andreasb242/WordClockPcb/Board-sw.png

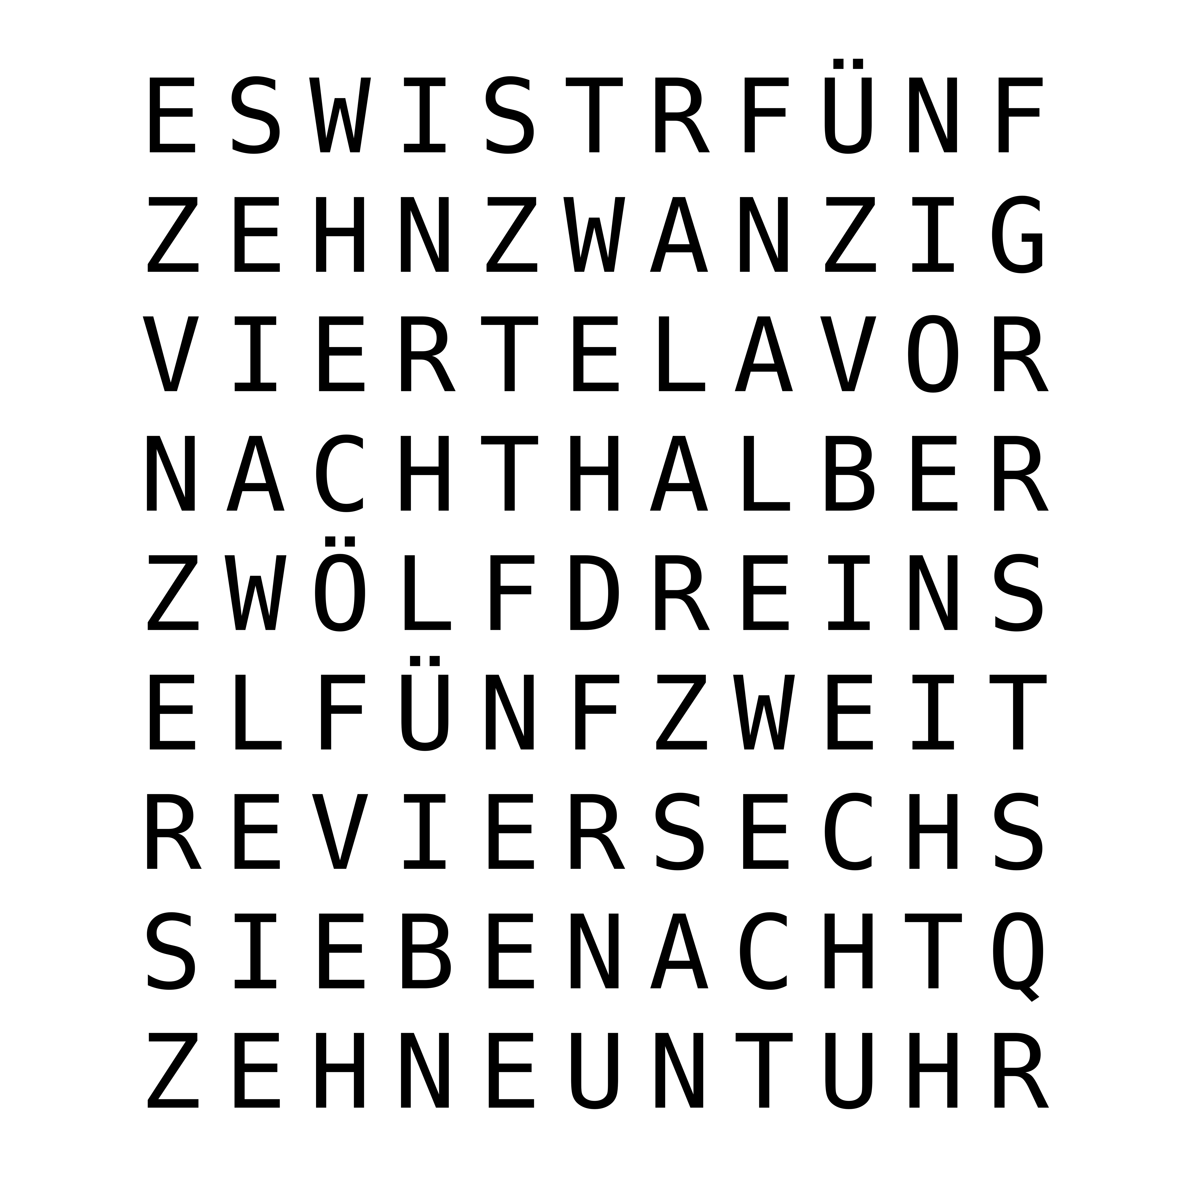
Board-sw.png
