andreasb242/WordClockPcb/Board-ws.png

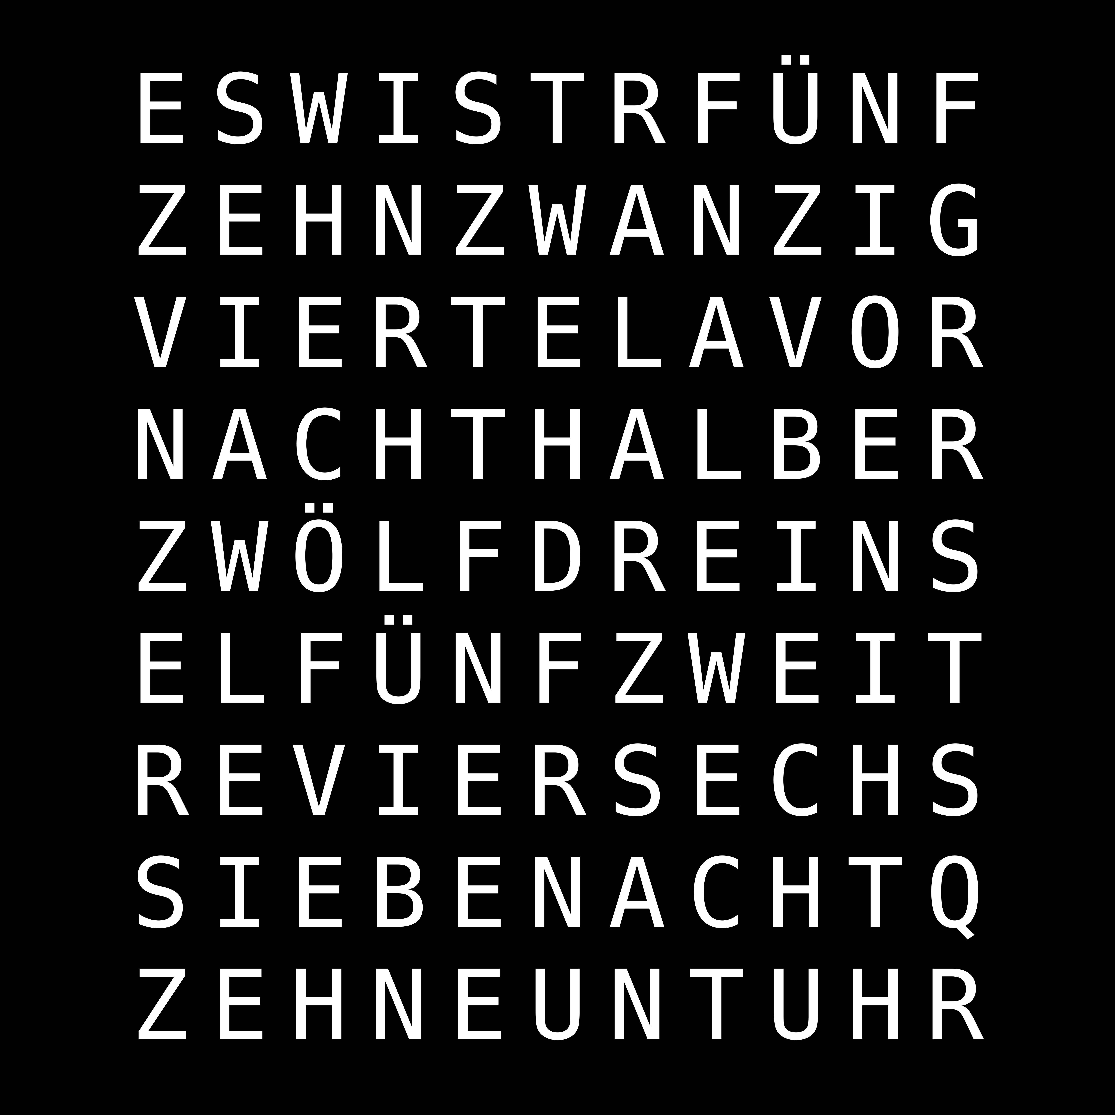
Board-ws.png
