andreasb242/WordClockPcb/ElektronikV2/gerber/BOM-Elektronik.csv.jlcpcb.xlsx

Comment | Designator | Footprint | LCSC Part #（optional）
Conn_01x04 | J10 | PinHeader_1x04_P2.54mm_Vertical | x
1kΩ | R535,R534,R533,R532,R529 | R_0402_1005Metric | C11702
blue | D535,D534,D533,D532,D529 | LED_0805_2012Metric_Pad1.15x1.40mm_HandSolder | C72041
CH552G | U6 | SOP-16_4.4x10.4mm_P1.27mm | C111292
Conn_01x02_Male | J9,J8,J7,J6 | PinHeader_1x02_P2.54mm_Vertical | x
Conn_01x05_Male | J5 | PinHeader_1x05_P2.54mm_Vertical | x
1uF | C9,C6 | C_0603_1608Metric | C15849
100nF | C8,C7,C5,C4,C3,C2,C1 | C_0603_1608Metric | C14663
TestPoint | TP3,TP2,TP1 | TestPoint_Pad_1.5x1.5mm
Crystal | Y1 | Crystal_SMD_3215-2Pin_3.2x1.5mm
PCF8563T | U5 | SOIC-8_3.9x4.9mm_P1.27mm | C7440
4.7kΩ | R531,R530 | R_0402_1005Metric | C25900
SM4007PL | D531,D530 | D_SOD-123F | C64898
Rled | R408,R407,R406,R405,R404,R403,R528,R527,R526,R525,R524,R523,R522,R521,R520,R519,R518,R517,R516,R515,R514,R513,R512,R511,R510,R509,R508,R507,R506,R505,R504,R503,R502,R501,R500,R499,R498,R497,R496,R495,R494,R493,R492,R491,R490,R489,R488,R487,R486,R485,R484,R483,R482,R481,R480,R479,R478,R477,R476,R475,R474,R473,R472,R471,R470,R469,R468,R467,R466,R465,R464,R463,R462,R461,R460,R459,R458,R457,R456,R455,R454,R453,R452,R451,R450,R449,R448,R447,R446,R445,R444,R443,R442,R441,R440,R439,R438,R437,R436,R435,R434,R433,R432,R431,R430,R429,R428,R427,R426,R425,R424,R423,R422,R421,R420,R419,R418,R417,R416,R415,R414,R413,R412,R411,R410,R409,R402,R401,R400,R399,R398,R397,R396,R395,R394,R393,R392,R391,R390,R389,R388,R387,R386,R385,R384,R383,R382,R381,R380,R379,R378,R377,R376,R375,R374,R373,R372,R371,R370,R369,R368,R367,R366,R365,R364,R363,R362,R361,R360,R359,R358,R357,R356,R355,R354,R353,R352,R351,R350,R349,R348,R347,R346,R345,R344,R343,R342,R341,R340,R339,R338,R337,R336,R335,R334,R333,R332,R331,R330,R329,R328,R327,R326,R325,R324,R323,R322,R321,R320,R319,R318,R317,R316,R315,R314,R313,R312,R311,R310,R309,R308,R307,R306,R305,R304,R303,R302,R301,R300,R299,R298,R297,R296,R295,R294,R293,R292,R291,R290,R289,R288,R287,R286,R285,R284,R283,R282,R281,R280,R279,R278,R277,R276,R275,R274,R273,R272,R271,R270,R269,R268,R267,R266,R265,R264,R263,R262,R261,R260,R259,R258,R257,R256,R255,R254,R253,R252,R251,R250,R249,R248,R247,R246,R245,R244,R243,R242,R241,R240,R239,R238,R237,R236,R235,R234,R233,R232,R231,R230,R22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 | R_0402_1005Metric
LEDCLOCK | D408,D407,D406,D405,D404,D403,D528,D527,D526,D525,D524,D523,D522,D521,D520,D519,D518,D517,D516,D515,D514,D513,D512,D511,D510,D509,D508,D507,D506,D505,D504,D503,D502,D501,D500,D499,D498,D497,D496,D495,D494,D493,D492,D491,D490,D489,D488,D487,D486,D485,D484,D483,D482,D481,D480,D479,D478,D477,D476,D475,D474,D473,D472,D471,D470,D469,D468,D467,D466,D465,D464,D463,D462,D461,D460,D459,D458,D457,D456,D455,D454,D453,D452,D451,D450,D449,D448,D447,D446,D445,D444,D443,D442,D441,D440,D439,D438,D437,D436,D435,D434,D433,D432,D431,D430,D429,D428,D427,D426,D425,D424,D423,D422,D421,D420,D419,D418,D417,D416,D415,D414,D413,D412,D411,D410,D409,D402,D401,D400,D399,D398,D397,D396,D395,D394,D393,D392,D391,D390,D389,D388,D387,D386,D385,D384,D383,D382,D381,D380,D379,D378,D377,D376,D375,D374,D373,D372,D371,D370,D369,D368,D367,D366,D365,D364,D363,D362,D361,D360,D359,D358,D357,D356,D355,D354,D353,D352,D351,D350,D349,D348,D347,D346,D345,D344,D343,D342,D341,D340,D339,D338,D337,D336,D335,D334,D333,D332,D331,D330,D329,D328,D327,D326,D325,D324,D323,D322,D321,D320,D319,D318,D317,D316,D315,D314,D313,D312,D311,D310,D309,D308,D307,D306,D305,D304,D303,D302,D301,D300,D299,D298,D297,D296,D295,D294,D293,D292,D291,D290,D289,D288,D287,D286,D285,D284,D283,D282,D281,D280,D279,D278,D277,D276,D275,D274,D273,D272,D271,D270,D269,D268,D267,D266,D265,D264,D263,D262,D261,D260,D259,D258,D257,D256,D255,D254,D253,D252,D251,D250,D249,D248,D247,D246,D245,D244,D243,D242,D241,D240,D239,D238,D237,D236,D235,D234,D233,D232,D231,D230,D22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 | LED_0603_1608Metric
74HC595 | U4,U3,U2,U1 | SOIC-16_3.9x9.9mm_P1.27mm | C5947
MountingHole_Pad | H4,H3,H2,H1 | MountingHole_4.3mm_M4_Pad_Via | x
Conn_02x04_Counter_Clockwise | J4,J3,J2,J1 | PinHeader_2x04_P2.54mm_Vertical | x
Graphics | G2 | sw
