andreasb242/WordClockPcb/ElektronikV2/Elektronik.kicad_pcb

## KiCad design ElektronikV2/Elektronik.kicad_pcb (2020-09-25)

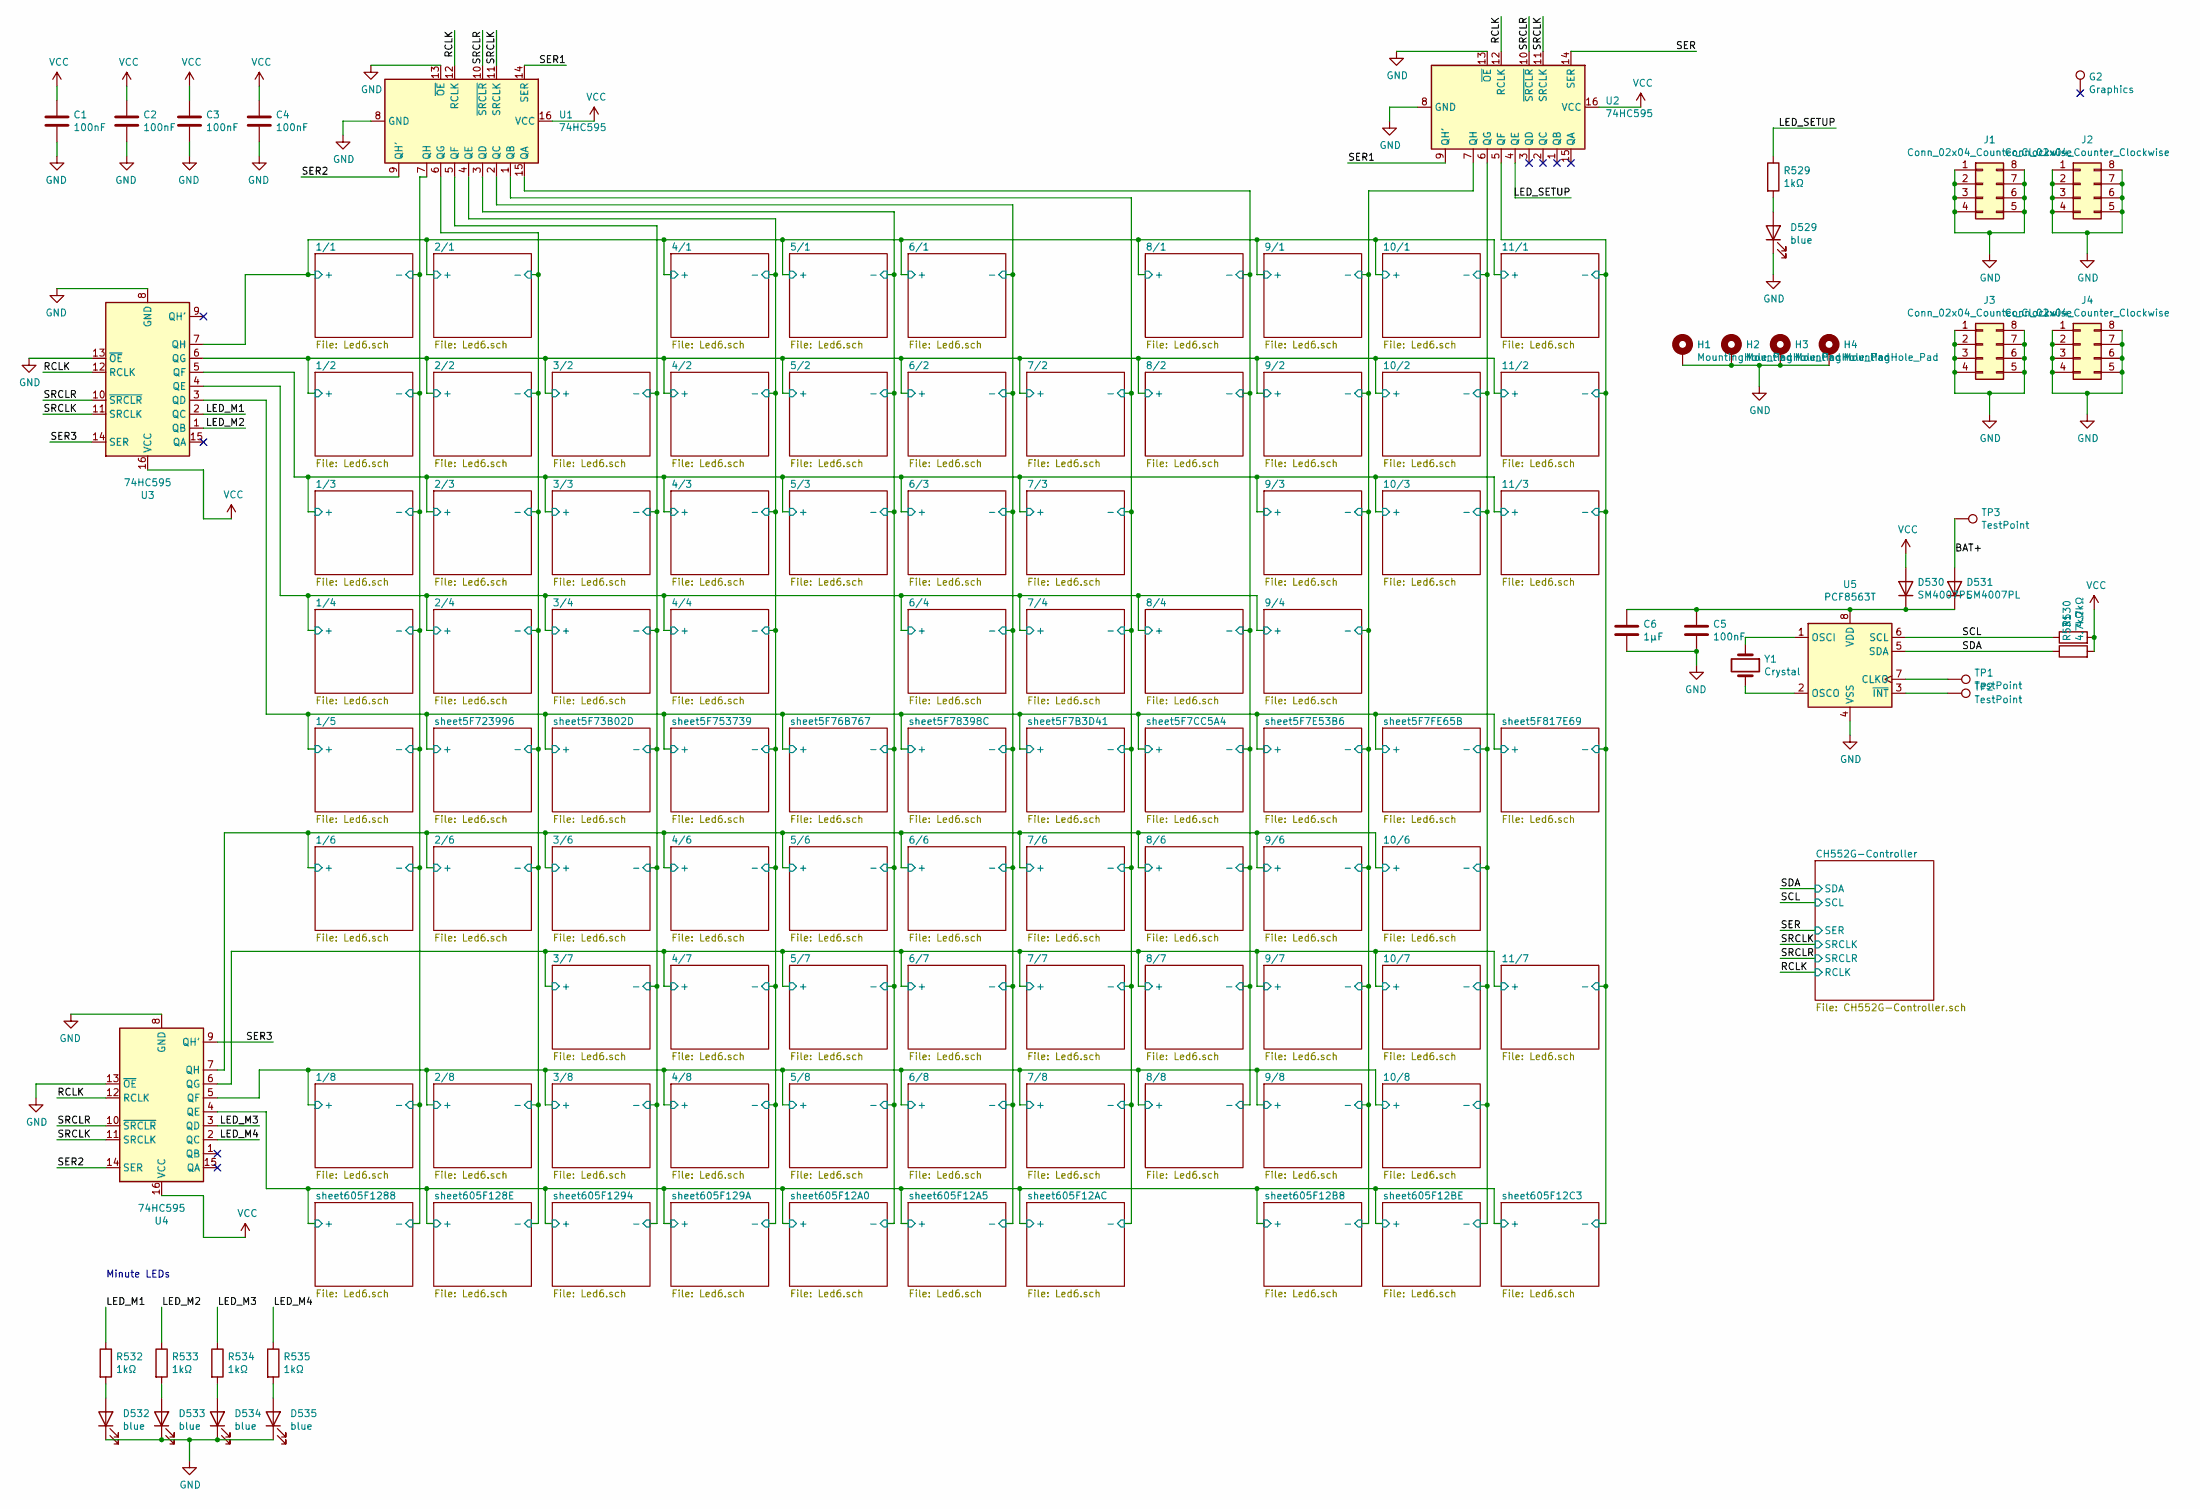
[picture p3: schematic Elektronik.sch]

Parts:
C1, C2, C3, C4, C5: 100nF; C_0603_1608Metric
C6: 1µF; C_0603_1608Metric
D529, D532, D533, D534, D535: blue; LED_0805_2012Metric_Pad1.15x1.40mm_HandSolder
D530, D531: SM4007PL; D_SOD-123F
G2: Graphics; sw
H1, H2, H3, H4: MountingHole_Pad; MountingHole_4.3mm_M4_Pad_Via
J1, J2, J3, J4: Conn_02x04_Counter_Clockwise; PinHeader_2x04_P2.54mm_Vertical
R529, R532, R533, R534, R535: 1kΩ; R_0402_1005Metric
R530, R531: 4.7kΩ; R_0402_1005Metric
TP1, TP2, TP3: TestPoint; TestPoint_Pad_1.5x1.5mm
U1, U2, U3, U4: 74HC595; SOIC-16_3.9x9.9mm_P1.27mm
U5: PCF8563T; SOIC-8_3.9x4.9mm_P1.27mm
Y1: Crystal; Crystal_SMD_3215-2Pin_3.2x1.5mm

Connections:
/1/1/+: U3.7 (QH); also elsewhere on the board
/1/1/-: U1.7 (QH); also elsewhere on the board
/1/2/+: U3.6 (QG); also elsewhere on the board
/1/3/+: U3.5 (QF); also elsewhere on the board
/1/4/+: U3.4 (QE); also elsewhere on the board
/1/5/+: U3.3 (QD); also elsewhere on the board
/1/6/+: U4.7 (QH); also elsewhere on the board
/1/8/+: U4.5 (QF); also elsewhere on the board
/2/1/-: U1.6 (QG); also elsewhere on the board
/3/2/-: U1.5 (QF); also elsewhere on the board
/4/1/-: U1.4 (QE); also elsewhere on the board
/5/1/-: U1.3 (QD); also elsewhere on the board
/6/1/-: U1.2 (QC); also elsewhere on the board
/7/2/-: U1.1 (QB); also elsewhere on the board
/8/1/-: U1.15 (QA); also elsewhere on the board
/9/1/-: U2.7 (QH); also elsewhere on the board
/10/1/-: U2.6 (QG); also elsewhere on the board
/10/7/+: U4.6 (QG); also elsewhere on the board
/11/1/-: U2.5 (QF); also elsewhere on the board
/BAT+: D531.2 (A), TP3.1
/LED_M1: R532.1, U3.2 (QC)
/LED_M2: R533.1, U3.1 (QB)
/LED_M3: R534.1, U4.3 (QD)
/LED_M4: R535.1, U4.2 (QC)
/LED_SETUP: R529.1, U2.4 (QE)
/RCLK: U1.12 (RCLK), U2.12 (RCLK), U3.12 (RCLK), U4.12 (RCLK); also elsewhere on the board
/SCL: R530.1, U5.6 (SCL); also elsewhere on the board
/SDA: R531.1, U5.5 (SDA); also elsewhere on the board
/SER: U2.14 (SER); also elsewhere on the board
/SER1: U1.14 (SER), U2.9 (QH')
/SER2: U1.9 (QH'), U4.14 (SER)
/SER3: U3.14 (SER), U4.9 (QH')
/SRCLK: U1.11 (SRCLK), U2.11 (SRCLK), U3.11 (SRCLK), U4.11 (SRCLK); also elsewhere on the board
/SRCLR: U1.10 (~SRCLR), U2.10 (~SRCLR), U3.10 (~SRCLR), U4.10 (~SRCLR); also elsewhere on the board
/sheet605F1288/+: U4.4 (QE); also elsewhere on the board
GND: C1.2, C2.2, C3.2, C4.2, C5.2, C6.2, D529.1 (K), D532.1 (K), D533.1 (K), D534.1 (K), D535.1 (K), H1.1, H2.1, H3.1, H4.1, J1.1, J1.2, J1.3, J1.4, J1.5, J1.6, J1.7, J1.8, J2.1, J2.2, J2.3, J2.4, J2.5, J2.6, J2.7, J2.8, J3.1, J3.2, J3.3, J3.4, J3.5, J3.6, J3.7, J3.8, J4.1, J4.2, J4.3, J4.4, J4.5, J4.6, J4.7, J4.8, U1.8 (GND), U1.13 (~OE), U2.8 (GND), U2.13 (~OE), U3.8 (GND), U3.13 (~OE), U4.8 (GND), U4.13 (~OE), U5.4 (VSS); also elsewhere on the board
unnamed: C5.1, C6.1, D530.1 (K), D531.1 (K), U5.8 (VDD)
unnamed: D529.2 (A), R529.2
unnamed: D532.2 (A), R532.2
unnamed: D533.2 (A), R533.2
unnamed: D534.2 (A), R534.2
unnamed: D535.2 (A), R535.2
unnamed: TP1.1, U5.7 (CLKO)
unnamed: TP2.1, U5.3 (~INT~)
unnamed: U5.1 (OSCI), Y1.1
unnamed: U5.2 (OSCO), Y1.2
VCC: C1.1, C2.1, C3.1, C4.1, D530.2 (A), R530.2, R531.2, U1.16 (VCC), U2.16 (VCC), U3.16 (VCC), U4.16 (VCC); also elsewhere on the board

Notes on the sheet:
Minute LEDs
