andreasb242/WordClockPcb/ElektronikV2/Elektronik.kicad_pcb

## KiCad design ElektronikV2/Elektronik.kicad_pcb (continued)

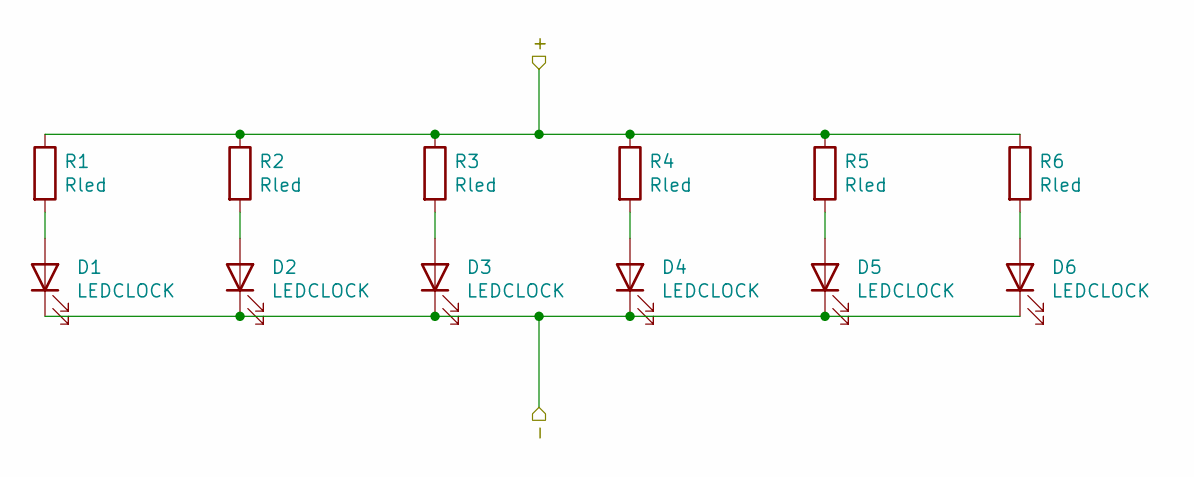
[picture p4: schematic Led6.sch]

Parts:
D1, D2, D3, D4, D5, D6: LEDCLOCK; LED_0603_1608Metric
R1, R2, R3, R4, R5, R6: Rled; R_0402_1005Metric

Connections:
/1/1/+: R1.1, R2.1, R3.1, R4.1, R5.1, R6.1; also elsewhere on the board
/1/1/-: D1.1 (K), D2.1 (K), D3.1 (K), D4.1 (K), D5.1 (K), D6.1 (K); also elsewhere on the board
unnamed: D1.2 (A), R1.2
unnamed: D2.2 (A), R2.2
unnamed: D3.2 (A), R3.2
unnamed: D4.2 (A), R4.2
unnamed: D5.2 (A), R5.2
unnamed: D6.2 (A), R6.2

Parts of its further copies:
D7, D8, D9, D10, D11, D12, D13, D14, D15, D16, D17, D18, D19, D20, D21, D22, D23, D24, D25, D26, D27, D28, D29, D30, D31, D32, D33, D34, D35, D36, D37, D38, D39, D40, D41, D42, D43, D44, D45, D46, D47, D48, D49, D50, D51, D52, D53, D54, D55, D56, D57, D58, D59, D60, D61, D62, D63, D64, D65, D66, D67, D68, D69, D70, D71, D72, D73, D74, D75, D76, D77, D78, D79, D80, D81, D82, D83, D84, D85, D86, D87, D88, D89, D90, D91, D92, D93, D94, D95, D96, D97, D98, D99, D100, D101, D102, D103, D104, D105, D106, D107, D108, D109, D110, D111, D112, D113, D114, D115, D116, D117, D118, D119, D120, D121, D122, D123, D124, D125, D126, D127, D128, D129, D130, D131, D132, D133, D134, D135, D136, D137, D138, D139, D140, D141, D142, D143, D144, D145, D146, D147, D148, D149, D150, D151, D152, D153, D154, D155, D156, D157, D158, D159, D160, D161, D162, D163, D164, D165, D166, D167, D168, D169, D170, D171, D172, D173, D174, D175, D176, D177, D178, D179, D180, D181, D182, D183, D184, D185, D186, D187, D188, D189, D190, D191, D192, D193, D194, D195, D196, D197, D198, D199, D200, D201, D202, D203, D204, D205, D206, D207, D208, D209, D210, D211, D212, D213, D214, D215, D216, D217, D218, D219, D220, D221, D222, D223, D224, D225, D226, D227, D228, D229, D230, D231, D232, D233, D234, D235, D236, D237, D238, D239, D240, D241, D242, D243, D244, D245, D246, D247, D248, D249, D250, D251, D252, D253, D254, D255, D256, D257, D258, D259, D260, D261, D262, D263, D264, D265, D266, D267, D268, D269, D270, D271, D272, D273, D274, D275, D276, D277, D278, D279, D280, D281, D282, D283, D284, D285, D286, D287, D288, D289, D290, D291, D292, D293, D294, D295, D296, D297, D298, D299, D300, D301, D302, D303, D304, D305, D306, D307, D308, D309, D310, D311, D312, D313, D314, D315, D316, D317, D318, D319, D320, D321, D322, D323, D324, D325, D326, D327, D328, D329, D330, D331, D332, D333, D334, D335, D336, D337, D338, D339, D340, D341, D342, D343, D344, D345, D346, D347, D348, D349, D350, D351, D352, D353, D354, D355, D356, D357, D358, D359, D360, D361, D362, D363, D364, D365, D366, D367, D368, D369, D370, D371, D372, D373, D374, D375, D376, D377, D378, D379, D380, D381, D382, D383, D384, D385, D386, D387, D388, D389, D390, D391, D392, D393, D394, D395, D396, D397, D398, D399, D400, D401, D402, D403, D404, D405, D406, D407, D408, D409, D410, D411, D412, D413, D414, D415, D416, D417, D418, D419, D420, D421, D422, D423, D424, D425, D426, D427, D428, D429, D430, D431, D432, D433, D434, D435, D436, D437, D438, D439, D440, D441, D442, D443, D444, D445, D446, D447, D448, D449, D450, D451, D452, D453, D454, D455, D456, D457, D458, D459, D460, D461, D462, D463, D464, D465, D466, D467, D468, D469, D470, D471, D472, D473, D474, D475, D476, D477, D478, D479, D480, D481, D482, D483, D484, D485, D486, D487, D488, D489, D490, D491, D492, D493, D494, D495, D496, D497, D498, D499, D500, D501, D502, D503, D504, D505, D506, D507, D508, D509, D510, D511, D512, D513, D514, D515, D516, D517, D518, D519, D520, D521, D522, D523, D524, D525, D526, D527, D528: LEDCLOCK; LED_0603_1608Metric
R7, R8, R9, R10, R11, R12, R13, R14, R15, R16, R17, R18, R19, R20, R21, R22, R23, R24, R25, R26, R27, R28, R29, R30, R31, R32, R33, R34, R35, R36, R37, R38, R39, R40, R41, R42, R43, R44, R45, R46, R47, R48, R49, R50, R51, R52, R53, R54, R55, R56, R57, R58, R59, R60, R61, R62, R63, R64, R65, R66, R67, R68, R69, R70, R71, R72, R73, R74, R75, R76, R77, R78, R79, R80, R81, R82, R83, R84, R85, R86, R87, R88, R89, R90, R91, R92, R93, R94, R95, R96, R97, R98, R99, R100, R101, R102, R103, R104, R105, R106, R107, R108, R109, R110, R111, R112, R113, R114, R115, R116, R117, R118, R119, R120, R121, R122, R123, R124, R125, R126, R127, R128, R129, R130, R131, R132, R133, R134, R135, R136, R137, R138, R139, R140, R141, R142, R143, R144, R145, R146, R147, R148, R149, R150, R151, R152, R153, R154, R155, R156, R157, R158, R159, R160, R161, R162, R163, R164, R165, R166, R167, R168, R169, R170, R171, R172, R173, R174, R175, R176, R177, R178, R179, R180, R181, R182, R183, R184, R185, R186, R187, R188, R189, R190, R191, R192, R193, R194, R195, R196, R197, R198, R199, R200, R201, R202, R203, R204, R205, R206, R207, R208, R209, R210, R211, R212, R213, R214, R215, R216, R217, R218, R219, R220, R221, R222, R223, R224, R225, R226, R227, R228, R229, R230, R231, R232, R233, R234, R235, R236, R237, R238, R239, R240, R241, R242, R243, R244, R245, R246, R247, R248, R249, R250, R251, R252, R253, R254, R255, R256, R257, R258, R259, R260, R261, R262, R263, R264, R265, R266, R267, R268, R269, R270, R271, R272, R273, R274, R275, R276, R277, R278, R279, R280, R281, R282, R283, R284, R285, R286, R287, R288, R289, R290, R291, R292, R293, R294, R295, R296, R297, R298, R299, R300, R301, R302, R303, R304, R305, R306, R307, R308, R309, R310, R311, R312, R313, R314, R315, R316, R317, R318, R319, R320, R321, R322, R323, R324, R325, R326, R327, R328, R329, R330, R331, R332, R333, R334, R335, R336, R337, R338, R339, R340, R341, R342, R343, R344, R345, R346, R347, R348, R349, R350, R351, R352, R353, R354, R355, R356, R357, R358, R359, R360, R361, R362, R363, R364, R365, R366, R367, R368, R369, R370, R371, R372, R373, R374, R375, R376, R377, R378, R379, R380, R381, R382, R383, R384, R385, R386, R387, R388, R389, R390, R391, R392, R393, R394, R395, R396, R397, R398, R399, R400, R401, R402, R403, R404, R405, R406, R407, R408, R409, R410, R411, R412, R413, R414, R415, R416, R417, R418, R419, R420, R421, R422, R423, R424, R425, R426, R427, R428, R429, R430, R431, R432, R433, R434, R435, R436, R437, R438, R439, R440, R441, R442, R443, R444, R445, R446, R447, R448, R449, R450, R451, R452, R453, R454, R455, R456, R457, R458, R459, R460, R461, R462, R463, R464, R465, R466, R467, R468, R469, R470, R471, R472, R473, R474, R475, R476, R477, R478, R479, R480, R481, R482, R483, R484, R485, R486, R487, R488, R489, R490, R491, R492, R493, R494, R495, R496, R497, R498, R499, R500, R501, R502, R503, R504, R505, R506, R507, R508, R509, R510, R511, R512, R513, R514, R515, R516, R517, R518, R519, R520, R521, R522, R523, R524, R525, R526, R527, R528: Rled; R_0402_1005Metric

Connections of its further copies:
/1/1/+: R7.1, R8.1, R9.1, R10.1, R11.1, R12.1, R13.1, R14.1, R15.1, R16.1, R17.1, R18.1, R19.1, R20.1, R21.1, R22.1, R23.1, R24.1, R25.1, R26.1, R27.1, R28.1, R29.1, R30.1, R31.1, R32.1, R33.1, R34.1, R35.1, R36.1, R37.1, R38.1, R39.1, R40.1, R41.1, R42.1, R43.1, R44.1, R45.1, R46.1, R47.1, R48.1, R49.1, R50.1, R51.1, R52.1, R53.1, R54.1; also elsewhere on the board
/1/1/-: D55.1 (K), D56.1 (K), D57.1 (K), D58.1 (K), D59.1 (K), D60.1 (K), D121.1 (K), D122.1 (K), D123.1 (K), D124.1 (K), D125.1 (K), D126.1 (K), D181.1 (K), D182.1 (K), D183.1 (K), D184.1 (K), D185.1 (K), D186.1 (K), D229.1 (K), D230.1 (K), D231.1 (K), D232.1 (K), D233.1 (K), D234.1 (K), D295.1 (K), D296.1 (K), D297.1 (K), D298.1 (K), D299.1 (K), D300.1 (K), D409.1 (K), D410.1 (K), D411.1 (K), D412.1 (K), D413.1 (K), D414.1 (K), D469.1 (K), D470.1 (K), D471.1 (K), D472.1 (K), D473.1 (K), D474.1 (K); also elsewhere on the board
/1/2/+: R55.1, R56.1, R57.1, R58.1, R59.1, R60.1, R61.1, R62.1, R63.1, R64.1, R65.1, R66.1, R67.1, R68.1, R69.1, R70.1, R71.1, R72.1, R73.1, R74.1, R75.1, R76.1, R77.1, R78.1, R79.1, R80.1, R81.1, R82.1, R83.1, R84.1, R85.1, R86.1, R87.1, R88.1, R89.1, R90.1, R91.1, R92.1, R93.1, R94.1, R95.1, R96.1, R97.1, R98.1, R99.1, R100.1, R101.1, R102.1, R103.1, R104.1, R105.1, R106.1, R107.1, R108.1, R109.1, R110.1, R111.1, R112.1, R113.1, R114.1, R115.1, R116.1, R117.1, R118.1, R119.1, R120.1; also elsewhere on the board
/1/3/+: R121.1, R122.1, R123.1, R124.1, R125.1, R126.1, R127.1, R128.1, R129.1, R130.1, R131.1, R132.1, R133.1, R134.1, R135.1, R136.1, R137.1, R138.1, R139.1, R140.1, R141.1, R142.1, R143.1, R144.1, R145.1, R146.1, R147.1, R148.1, R149.1, R150.1, R151.1, R152.1, R153.1, R154.1, R155.1, R156.1, R157.1, R158.1, R159.1, R160.1, R161.1, R162.1, R163.1, R164.1, R165.1, R166.1, R167.1, R168.1, R169.1, R170.1, R171.1, R172.1, R173.1, R174.1, R175.1, R176.1, R177.1, R178.1, R179.1, R180.1; also elsewhere on the board
/1/4/+: R181.1, R182.1, R183.1, R184.1, R185.1, R186.1, R187.1, R188.1, R189.1, R190.1, R191.1, R192.1, R193.1, R194.1, R195.1, R196.1, R197.1, R198.1, R199.1, R200.1, R201.1, R202.1, R203.1, R204.1, R205.1, R206.1, R207.1, R208.1, R209.1, R210.1, R211.1, R212.1, R213.1, R214.1, R215.1, R216.1, R217.1, R218.1, R219.1, R220.1, R221.1, R222.1, R223.1, R224.1, R225.1, R226.1, R227.1, R228.1; also elsewhere on the board
/1/5/+: R229.1, R230.1, R231.1, R232.1, R233.1, R234.1, R235.1, R236.1, R237.1, R238.1, R239.1, R240.1, R241.1, R242.1, R243.1, R244.1, R245.1, R246.1, R247.1, R248.1, R249.1, R250.1, R251.1, R252.1, R253.1, R254.1, R255.1, R256.1, R257.1, R258.1, R259.1, R260.1, R261.1, R262.1, R263.1, R264.1, R265.1, R266.1, R267.1, R268.1, R269.1, R270.1, R271.1, R272.1, R273.1, R274.1, R275.1, R276.1, R277.1, R278.1, R279.1, R280.1, R281.1, R282.1, R283.1, R284.1, R285.1, R286.1, R287.1, R288.1, R289.1, R290.1, R291.1, R292.1, R293.1, R294.1; also elsewhere on the board
/1/6/+: R295.1, R296.1, R297.1, R298.1, R299.1, R300.1, R301.1, R302.1, R303.1, R304.1, R305.1, R306.1, R307.1, R308.1, R309.1, R310.1, R311.1, R312.1, R313.1, R314.1, R315.1, R316.1, R317.1, R318.1, R319.1, R320.1, R321.1, R322.1, R323.1, R324.1, R325.1, R326.1, R327.1, R328.1, R329.1, R330.1, R331.1, R332.1, R333.1, R334.1, R335.1, R336.1, R337.1, R338.1, R339.1, R340.1, R341.1, R342.1, R343.1, R344.1, R345.1, R346.1, R347.1, R348.1, R349.1, R350.1, R351.1, R352.1, R353.1, R354.1; also elsewhere on the board
/1/8/+: R409.1, R410.1, R411.1, R412.1, R413.1, R414.1, R415.1, R416.1, R417.1, R418.1, R419.1, R420.1, R421.1, R422.1, R423.1, R424.1, R425.1, R426.1, R427.1, R428.1, R429.1, R430.1, R431.1, R432.1, R433.1, R434.1, R435.1, R436.1, R437.1, R438.1, R439.1, R440.1, R441.1, R442.1, R443.1, R444.1, R445.1, R446.1, R447.1, R448.1, R449.1, R450.1, R451.1, R452.1, R453.1, R454.1, R455.1, R456.1, R457.1, R458.1, R459.1, R460.1, R461.1, R462.1, R463.1, R464.1, R465.1, R466.1, R467.1, R468.1; also elsewhere on the board
/2/1/-: D7.1 (K), D8.1 (K), D9.1 (K), D10.1 (K), D11.1 (K), D12.1 (K), D61.1 (K), D62.1 (K), D63.1 (K), D64.1 (K), D65.1 (K), D66.1 (K), D127.1 (K), D128.1 (K), D129.1 (K), D130.1 (K), D131.1 (K), D132.1 (K), D187.1 (K), D188.1 (K), D189.1 (K), D190.1 (K), D191.1 (K), D192.1 (K), D235.1 (K), D236.1 (K), D237.1 (K), D238.1 (K), D239.1 (K), D240.1 (K), D301.1 (K), D302.1 (K), D303.1 (K), D304.1 (K), D305.1 (K), D306.1 (K), D415.1 (K), D416.1 (K), D417.1 (K), D418.1 (K), D419.1 (K), D420.1 (K), D475.1 (K), D476.1 (K), D477.1 (K), D478.1 (K), D479.1 (K), D480.1 (K); also elsewhere on the board
/3/2/-: D67.1 (K), D68.1 (K), D69.1 (K), D70.1 (K), D71.1 (K), D72.1 (K), D133.1 (K), D134.1 (K), D135.1 (K), D136.1 (K), D137.1 (K), D138.1 (K), D193.1 (K), D194.1 (K), D195.1 (K), D196.1 (K), D197.1 (K), D198.1 (K), D241.1 (K), D242.1 (K), D243.1 (K), D244.1 (K), D245.1 (K), D246.1 (K), D307.1 (K), D308.1 (K), D309.1 (K), D310.1 (K), D311.1 (K), D312.1 (K), D355.1 (K), D356.1 (K), D357.1 (K), D358.1 (K), D359.1 (K), D360.1 (K), D421.1 (K), D422.1 (K), D423.1 (K), D424.1 (K), D425.1 (K), D426.1 (K), D481.1 (K), D482.1 (K), D483.1 (K), D484.1 (K), D485.1 (K), D486.1 (K); also elsewhere on the board
/4/1/-: D13.1 (K), D14.1 (K), D15.1 (K), D16.1 (K), D17.1 (K), D18.1 (K), D73.1 (K), D74.1 (K), D75.1 (K), D76.1 (K), D77.1 (K), D78.1 (K), D139.1 (K), D140.1 (K), D141.1 (K), D142.1 (K), D143.1 (K), D144.1 (K), D199.1 (K), D200.1 (K), D201.1 (K), D202.1 (K), D203.1 (K), D204.1 (K), D247.1 (K), D248.1 (K), D249.1 (K), D250.1 (K), D251.1 (K), D252.1 (K), D313.1 (K), D314.1 (K), D315.1 (K), D316.1 (K), D317.1 (K), D318.1 (K), D361.1 (K), D362.1 (K), D363.1 (K), D364.1 (K), D365.1 (K), D366.1 (K), D427.1 (K), D428.1 (K), D429.1 (K), D430.1 (K), D431.1 (K), D432.1 (K), D487.1 (K), D488.1 (K), D489.1 (K), D490.1 (K), D491.1 (K), D492.1 (K); also elsewhere on the board
/5/1/-: D19.1 (K), D20.1 (K), D21.1 (K), D22.1 (K), D23.1 (K), D24.1 (K), D79.1 (K), D80.1 (K), D81.1 (K), D82.1 (K), D83.1 (K), D84.1 (K), D145.1 (K), D146.1 (K), D147.1 (K), D148.1 (K), D149.1 (K), D150.1 (K), D253.1 (K), D254.1 (K), D255.1 (K), D256.1 (K), D257.1 (K), D258.1 (K), D319.1 (K), D320.1 (K), D321.1 (K), D322.1 (K), D323.1 (K), D324.1 (K), D367.1 (K), D368.1 (K), D369.1 (K), D370.1 (K), D371.1 (K), D372.1 (K), D433.1 (K), D434.1 (K), D435.1 (K), D436.1 (K), D437.1 (K), D438.1 (K), D493.1 (K), D494.1 (K), D495.1 (K), D496.1 (K), D497.1 (K), D498.1 (K); also elsewhere on the board
/6/1/-: D25.1 (K), D26.1 (K), D27.1 (K), D28.1 (K), D29.1 (K), D30.1 (K), D85.1 (K), D86.1 (K), D87.1 (K), D88.1 (K), D89.1 (K), D90.1 (K), D151.1 (K), D152.1 (K), D153.1 (K), D154.1 (K), D155.1 (K), D156.1 (K), D205.1 (K), D206.1 (K), D207.1 (K), D208.1 (K), D209.1 (K), D210.1 (K), D259.1 (K), D260.1 (K), D261.1 (K), D262.1 (K), D263.1 (K), D264.1 (K), D325.1 (K), D326.1 (K), D327.1 (K), D328.1 (K), D329.1 (K), D330.1 (K), D373.1 (K), D374.1 (K), D375.1 (K), D376.1 (K), D377.1 (K), D378.1 (K), D439.1 (K), D440.1 (K), D441.1 (K), D442.1 (K), D443.1 (K), D444.1 (K), D499.1 (K), D500.1 (K), D501.1 (K), D502.1 (K), D503.1 (K), D504.1 (K); also elsewhere on the board
/7/2/-: D91.1 (K), D92.1 (K), D93.1 (K), D94.1 (K), D95.1 (K), D96.1 (K), D157.1 (K), D158.1 (K), D159.1 (K), D160.1 (K), D161.1 (K), D162.1 (K), D211.1 (K), D212.1 (K), D213.1 (K), D214.1 (K), D215.1 (K), D216.1 (K), D265.1 (K), D266.1 (K), D267.1 (K), D268.1 (K), D269.1 (K), D270.1 (K), D331.1 (K), D332.1 (K), D333.1 (K), D334.1 (K), D335.1 (K), D336.1 (K), D379.1 (K), D380.1 (K), D381.1 (K), D382.1 (K), D383.1 (K), D384.1 (K), D445.1 (K), D446.1 (K), D447.1 (K), D448.1 (K), D449.1 (K), D450.1 (K), D505.1 (K), D506.1 (K), D507.1 (K), D508.1 (K), D509.1 (K), D510.1 (K); also elsewhere on the board
/8/1/-: D31.1 (K), D32.1 (K), D33.1 (K), D34.1 (K), D35.1 (K), D36.1 (K), D97.1 (K), D98.1 (K), D99.1 (K), D100.1 (K), D101.1 (K), D102.1 (K), D217.1 (K), D218.1 (K), D219.1 (K), D220.1 (K), D221.1 (K), D222.1 (K), D271.1 (K), D272.1 (K), D273.1 (K), D274.1 (K), D275.1 (K), D276.1 (K), D337.1 (K), D338.1 (K), D339.1 (K), D340.1 (K), D341.1 (K), D342.1 (K), D385.1 (K), D386.1 (K), D387.1 (K), D388.1 (K), D389.1 (K), D390.1 (K), D451.1 (K), D452.1 (K), D453.1 (K), D454.1 (K), D455.1 (K), D456.1 (K); also elsewhere on the board
/9/1/-: D37.1 (K), D38.1 (K), D39.1 (K), D40.1 (K), D41.1 (K), D42.1 (K), D103.1 (K), D104.1 (K), D105.1 (K), D106.1 (K), D107.1 (K), D108.1 (K), D163.1 (K), D164.1 (K), D165.1 (K), D166.1 (K), D167.1 (K), D168.1 (K), D223.1 (K), D224.1 (K), D225.1 (K), D226.1 (K), D227.1 (K), D228.1 (K), D277.1 (K), D278.1 (K), D279.1 (K), D280.1 (K), D281.1 (K), D282.1 (K), D343.1 (K), D344.1 (K), D345.1 (K), D346.1 (K), D347.1 (K), D348.1 (K), D391.1 (K), D392.1 (K), D393.1 (K), D394.1 (K), D395.1 (K), D396.1 (K), D457.1 (K), D458.1 (K), D459.1 (K), D460.1 (K), D461.1 (K), D462.1 (K), D511.1 (K), D512.1 (K), D513.1 (K), D514.1 (K), D515.1 (K), D516.1 (K); also elsewhere on the board
/10/1/-: D43.1 (K), D44.1 (K), D45.1 (K), D46.1 (K), D47.1 (K), D48.1 (K), D109.1 (K), D110.1 (K), D111.1 (K), D112.1 (K), D113.1 (K), D114.1 (K), D169.1 (K), D170.1 (K), D171.1 (K), D172.1 (K), D173.1 (K), D174.1 (K), D283.1 (K), D284.1 (K), D285.1 (K), D286.1 (K), D287.1 (K), D288.1 (K), D349.1 (K), D350.1 (K), D351.1 (K), D352.1 (K), D353.1 (K), D354.1 (K), D397.1 (K), D398.1 (K), D399.1 (K), D400.1 (K), D401.1 (K), D402.1 (K), D463.1 (K), D464.1 (K), D465.1 (K), D466.1 (K), D467.1 (K), D468.1 (K), D517.1 (K), D518.1 (K), D519.1 (K), D520.1 (K), D521.1 (K), D522.1 (K); also elsewhere on the board
/10/7/+: R355.1, R356.1, R357.1, R358.1, R359.1, R360.1, R361.1, R362.1, R363.1, R364.1, R365.1, R366.1, R367.1, R368.1, R369.1, R370.1, R371.1, R372.1, R373.1, R374.1, R375.1, R376.1, R377.1, R378.1, R379.1, R380.1, R381.1, R382.1, R383.1, R384.1, R385.1, R386.1, R387.1, R388.1, R389.1, R390.1, R391.1, R392.1, R393.1, R394.1, R395.1, R396.1, R397.1, R398.1, R399.1, R400.1, R401.1, R402.1, R403.1, R404.1, R405.1, R406.1, R407.1, R408.1; also elsewhere on the board
/11/1/-: D49.1 (K), D50.1 (K), D51.1 (K), D52.1 (K), D53.1 (K), D54.1 (K), D115.1 (K), D116.1 (K), D117.1 (K), D118.1 (K), D119.1 (K), D120.1 (K), D175.1 (K), D176.1 (K), D177.1 (K), D178.1 (K), D179.1 (K), D180.1 (K), D289.1 (K), D290.1 (K), D291.1 (K), D292.1 (K), D293.1 (K), D294.1 (K), D403.1 (K), D404.1 (K), D405.1 (K), D406.1 (K), D407.1 (K), D408.1 (K), D523.1 (K), D524.1 (K), D525.1 (K), D526.1 (K), D527.1 (K), D528.1 (K); also elsewhere on the board
/sheet605F1288/+: R469.1, R470.1, R471.1, R472.1, R473.1, R474.1, R475.1, R476.1, R477.1, R478.1, R479.1, R480.1, R481.1, R482.1, R483.1, R484.1, R485.1, R486.1, R487.1, R488.1, R489.1, R490.1, R491.1, R492.1, R493.1, R494.1, R495.1, R496.1, R497.1, R498.1, R499.1, R500.1, R501.1, R502.1, R503.1, R504.1, R505.1, R506.1, R507.1, R508.1, R509.1, R510.1, R511.1, R512.1, R513.1, R514.1, R515.1, R516.1, R517.1, R518.1, R519.1, R520.1, R521.1, R522.1, R523.1, R524.1, R525.1, R526.1, R527.1, R528.1; also elsewhere on the board
unnamed: D7.2 (A), R7.2
unnamed: D8.2 (A), R8.2
unnamed: D9.2 (A), R9.2
unnamed: D10.2 (A), R10.2
unnamed: D11.2 (A), R11.2
unnamed: D12.2 (A), R12.2
unnamed: D13.2 (A), R13.2
unnamed: D14.2 (A), R14.2
unnamed: D15.2 (A), R15.2
unnamed: D16.2 (A), R16.2
unnamed: D17.2 (A), R17.2
unnamed: D18.2 (A), R18.2
unnamed: D19.2 (A), R19.2
unnamed: D20.2 (A), R20.2
unnamed: D21.2 (A), R21.2
unnamed: D22.2 (A), R22.2
unnamed: D23.2 (A), R23.2
unnamed: D24.2 (A), R24.2
unnamed: D25.2 (A), R25.2
unnamed: D26.2 (A), R26.2
unnamed: D27.2 (A), R27.2
unnamed: D28.2 (A), R28.2
unnamed: D29.2 (A), R29.2
unnamed: D30.2 (A), R30.2
unnamed: D31.2 (A), R31.2
unnamed: D32.2 (A), R32.2
unnamed: D33.2 (A), R33.2
unnamed: D34.2 (A), R34.2
unnamed: D35.2 (A), R35.2
unnamed: D36.2 (A), R36.2
unnamed: D37.2 (A), R37.2
unnamed: D38.2 (A), R38.2
unnamed: D39.2 (A), R39.2
unnamed: D40.2 (A), R40.2
unnamed: D41.2 (A), R41.2
unnamed: D42.2 (A), R42.2
unnamed: D43.2 (A), R43.2
unnamed: D44.2 (A), R44.2
unnamed: D45.2 (A), R45.2
unnamed: D46.2 (A), R46.2
unnamed: D47.2 (A), R47.2
unnamed: D48.2 (A), R48.2
unnamed: D49.2 (A), R49.2
unnamed: D50.2 (A), R50.2
unnamed: D51.2 (A), R51.2
unnamed: D52.2 (A), R52.2
unnamed: D53.2 (A), R53.2
unnamed: D54.2 (A), R54.2
unnamed: D55.2 (A), R55.2
unnamed: D56.2 (A), R56.2
unnamed: D57.2 (A), R57.2
unnamed: D58.2 (A), R58.2
unnamed: D59.2 (A), R59.2
unnamed: D60.2 (A), R60.2
unnamed: D61.2 (A), R61.2
unnamed: D62.2 (A), R62.2
unnamed: D63.2 (A), R63.2
unnamed: D64.2 (A), R64.2
unnamed: D65.2 (A), R65.2
unnamed: D66.2 (A), R66.2
unnamed: D67.2 (A), R67.2
unnamed: D68.2 (A), R68.2
unnamed: D69.2 (A), R69.2
unnamed: D70.2 (A), R70.2
unnamed: D71.2 (A), R71.2
unnamed: D72.2 (A), R72.2
unnamed: D73.2 (A), R73.2
unnamed: D74.2 (A), R74.2
unnamed: D75.2 (A), R75.2
unnamed: D76.2 (A), R76.2
unnamed: D77.2 (A), R77.2
unnamed: D78.2 (A), R78.2
unnamed: D79.2 (A), R79.2
unnamed: D80.2 (A), R80.2
unnamed: D81.2 (A), R81.2
unnamed: D82.2 (A), R82.2
unnamed: D83.2 (A), R83.2
unnamed: D84.2 (A), R84.2
unnamed: D85.2 (A), R85.2
unnamed: D86.2 (A), R86.2
unnamed: D87.2 (A), R87.2
unnamed: D88.2 (A), R88.2
unnamed: D89.2 (A), R89.2
unnamed: D90.2 (A), R90.2
unnamed: D91.2 (A), R91.2
unnamed: D92.2 (A), R92.2
unnamed: D93.2 (A), R93.2
unnamed: D94.2 (A), R94.2
unnamed: D95.2 (A), R95.2
unnamed: D96.2 (A), R96.2
unnamed: D97.2 (A), R97.2
unnamed: D98.2 (A), R98.2
unnamed: D99.2 (A), R99.2
unnamed: D100.2 (A), R100.2
unnamed: D101.2 (A), R101.2
unnamed: D102.2 (A), R102.2
unnamed: D103.2 (A), R103.2
unnamed: D104.2 (A), R104.2
unnamed: D105.2 (A), R105.2
unnamed: D106.2 (A), R106.2
unnamed: D107.2 (A), R107.2
unnamed: D108.2 (A), R108.2
unnamed: D109.2 (A), R109.2
unnamed: D110.2 (A), R110.2
unnamed: D111.2 (A), R111.2
unnamed: D112.2 (A), R112.2
unnamed: D113.2 (A), R113.2
unnamed: D114.2 (A), R114.2
unnamed: D115.2 (A), R115.2
unnamed: D116.2 (A), R116.2
unnamed: D117.2 (A), R117.2
unnamed: D118.2 (A), R118.2
unnamed: D119.2 (A), R119.2
unnamed: D120.2 (A), R120.2
unnamed: D121.2 (A), R121.2
unnamed: D122.2 (A), R122.2
unnamed: D123.2 (A), R123.2
unnamed: D124.2 (A), R124.2
unnamed: D125.2 (A), R125.2
unnamed: D126.2 (A), R126.2
unnamed: D127.2 (A), R127.2
unnamed: D128.2 (A), R128.2
unnamed: D129.2 (A), R129.2
unnamed: D130.2 (A), R130.2
unnamed: D131.2 (A), R131.2
unnamed: D132.2 (A), R132.2
unnamed: D133.2 (A), R133.2
unnamed: D134.2 (A), R134.2
unnamed: D135.2 (A), R135.2
unnamed: D136.2 (A), R136.2
unnamed: D137.2 (A), R137.2
unnamed: D138.2 (A), R138.2
unnamed: D139.2 (A), R139.2
unnamed: D140.2 (A), R140.2
unnamed: D141.2 (A), R141.2
unnamed: D142.2 (A), R142.2
unnamed: D143.2 (A), R143.2
unnamed: D144.2 (A), R144.2
unnamed: D145.2 (A), R145.2
unnamed: D146.2 (A), R146.2
unnamed: D147.2 (A), R147.2
unnamed: D148.2 (A), R148.2
unnamed: D149.2 (A), R149.2
unnamed: D150.2 (A), R150.2
unnamed: D151.2 (A), R151.2
unnamed: D152.2 (A), R152.2
unnamed: D153.2 (A), R153.2
unnamed: D154.2 (A), R154.2
unnamed: D155.2 (A), R155.2
unnamed: D156.2 (A), R156.2
unnamed: D157.2 (A), R157.2
unnamed: D158.2 (A), R158.2
unnamed: D159.2 (A), R159.2
unnamed: D160.2 (A), R160.2
unnamed: D161.2 (A), R161.2
unnamed: D162.2 (A), R162.2
unnamed: D163.2 (A), R163.2
unnamed: D164.2 (A), R164.2
unnamed: D165.2 (A), R165.2
unnamed: D166.2 (A), R166.2
unnamed: D167.2 (A), R167.2
unnamed: D168.2 (A), R168.2
unnamed: D169.2 (A), R169.2
unnamed: D170.2 (A), R170.2
unnamed: D171.2 (A), R171.2
unnamed: D172.2 (A), R172.2
unnamed: D173.2 (A), R173.2
unnamed: D174.2 (A), R174.2
unnamed: D175.2 (A), R175.2
unnamed: D176.2 (A), R176.2
unnamed: D177.2 (A), R177.2
unnamed: D178.2 (A), R178.2
unnamed: D179.2 (A), R179.2
unnamed: D180.2 (A), R180.2
unnamed: D181.2 (A), R181.2
unnamed: D182.2 (A), R182.2
unnamed: D183.2 (A), R183.2
unnamed: D184.2 (A), R184.2
unnamed: D185.2 (A), R185.2
unnamed: D186.2 (A), R186.2
unnamed: D187.2 (A), R187.2
unnamed: D188.2 (A), R188.2
unnamed: D189.2 (A), R189.2
unnamed: D190.2 (A), R190.2
unnamed: D191.2 (A), R191.2
unnamed: D192.2 (A), R192.2
unnamed: D193.2 (A), R193.2
unnamed: D194.2 (A), R194.2
unnamed: D195.2 (A), R195.2
unnamed: D196.2 (A), R196.2
unnamed: D197.2 (A), R197.2
unnamed: D198.2 (A), R198.2
unnamed: D199.2 (A), R199.2
unnamed: D200.2 (A), R200.2
unnamed: D201.2 (A), R201.2
unnamed: D202.2 (A), R202.2
unnamed: D203.2 (A), R203.2
unnamed: D204.2 (A), R204.2
unnamed: D205.2 (A), R205.2
unnamed: D206.2 (A), R206.2
unnamed: D207.2 (A), R207.2
unnamed: D208.2 (A), R208.2
unnamed: D209.2 (A), R209.2
unnamed: D210.2 (A), R210.2
unnamed: D211.2 (A), R211.2
unnamed: D212.2 (A), R212.2
unnamed: D213.2 (A), R213.2
unnamed: D214.2 (A), R214.2
unnamed: D215.2 (A), R215.2
unnamed: D216.2 (A), R216.2
unnamed: D217.2 (A), R217.2
unnamed: D218.2 (A), R218.2
unnamed: D219.2 (A), R219.2
unnamed: D220.2 (A), R220.2
unnamed: D221.2 (A), R221.2
unnamed: D222.2 (A), R222.2
unnamed: D223.2 (A), R223.2
unnamed: D224.2 (A), R224.2
unnamed: D225.2 (A), R225.2
unnamed: D226.2 (A), R226.2
unnamed: D227.2 (A), R227.2
unnamed: D228.2 (A), R228.2
unnamed: D229.2 (A), R229.2
unnamed: D230.2 (A), R230.2
unnamed: D231.2 (A), R231.2
unnamed: D232.2 (A), R232.2
unnamed: D233.2 (A), R233.2
unnamed: D234.2 (A), R234.2
unnamed: D235.2 (A), R235.2
unnamed: D236.2 (A), R236.2
unnamed: D237.2 (A), R237.2
unnamed: D238.2 (A), R238.2
unnamed: D239.2 (A), R239.2
unnamed: D240.2 (A), R240.2
unnamed: D241.2 (A), R241.2
unnamed: D242.2 (A), R242.2
unnamed: D243.2 (A), R243.2
unnamed: D244.2 (A), R244.2
unnamed: D245.2 (A), R245.2
unnamed: D246.2 (A), R246.2
unnamed: D247.2 (A), R247.2
unnamed: D248.2 (A), R248.2
unnamed: D249.2 (A), R249.2
unnamed: D250.2 (A), R250.2
unnamed: D251.2 (A), R251.2
unnamed: D252.2 (A), R252.2
unnamed: D253.2 (A), R253.2
unnamed: D254.2 (A), R254.2
unnamed: D255.2 (A), R255.2
unnamed: D256.2 (A), R256.2
unnamed: D257.2 (A), R257.2
unnamed: D258.2 (A), R258.2
unnamed: D259.2 (A), R259.2
unnamed: D260.2 (A), R260.2
unnamed: D261.2 (A), R261.2
unnamed: D262.2 (A), R262.2
unnamed: D263.2 (A), R263.2
unnamed: D264.2 (A), R264.2
unnamed: D265.2 (A), R265.2
unnamed: D266.2 (A), R266.2
unnamed: D267.2 (A), R267.2
unnamed: D268.2 (A), R268.2
unnamed: D269.2 (A), R269.2
unnamed: D270.2 (A), R270.2
unnamed: D271.2 (A), R271.2
unnamed: D272.2 (A), R272.2
unnamed: D273.2 (A), R273.2
unnamed: D274.2 (A), R274.2
unnamed: D275.2 (A), R275.2
unnamed: D276.2 (A), R276.2
unnamed: D277.2 (A), R277.2
unnamed: D278.2 (A), R278.2
unnamed: D279.2 (A), R279.2
unnamed: D280.2 (A), R280.2
unnamed: D281.2 (A), R281.2
unnamed: D282.2 (A), R282.2
unnamed: D283.2 (A), R283.2
unnamed: D284.2 (A), R284.2
unnamed: D285.2 (A), R285.2
unnamed: D286.2 (A), R286.2
unnamed: D287.2 (A), R287.2
unnamed: D288.2 (A), R288.2
unnamed: D289.2 (A), R289.2
unnamed: D290.2 (A), R290.2
unnamed: D291.2 (A), R291.2
unnamed: D292.2 (A), R292.2
unnamed: D293.2 (A), R293.2
unnamed: D294.2 (A), R294.2
unnamed: D295.2 (A), R295.2
unnamed: D296.2 (A), R296.2
unnamed: D297.2 (A), R297.2
unnamed: D298.2 (A), R298.2
unnamed: D299.2 (A), R299.2
unnamed: D300.2 (A), R300.2
unnamed: D301.2 (A), R301.2
unnamed: D302.2 (A), R302.2
unnamed: D303.2 (A), R303.2
unnamed: D304.2 (A), R304.2
unnamed: D305.2 (A), R305.2
unnamed: D306.2 (A), R306.2
unnamed: D307.2 (A), R307.2
unnamed: D308.2 (A), R308.2
unnamed: D309.2 (A), R309.2
unnamed: D310.2 (A), R310.2
unnamed: D311.2 (A), R311.2
unnamed: D312.2 (A), R312.2
unnamed: D313.2 (A), R313.2
unnamed: D314.2 (A), R314.2
unnamed: D315.2 (A), R315.2
unnamed: D316.2 (A), R316.2
unnamed: D317.2 (A), R317.2
unnamed: D318.2 (A), R318.2
unnamed: D319.2 (A), R319.2
unnamed: D320.2 (A), R320.2
unnamed: D321.2 (A), R321.2
unnamed: D322.2 (A), R322.2
unnamed: D323.2 (A), R323.2
unnamed: D324.2 (A), R324.2
unnamed: D325.2 (A), R325.2
unnamed: D326.2 (A), R326.2
unnamed: D327.2 (A), R327.2
unnamed: D328.2 (A), R328.2
unnamed: D329.2 (A), R329.2
unnamed: D330.2 (A), R330.2
unnamed: D331.2 (A), R331.2
unnamed: D332.2 (A), R332.2
unnamed: D333.2 (A), R333.2
unnamed: D334.2 (A), R334.2
unnamed: D335.2 (A), R335.2
unnamed: D336.2 (A), R336.2
unnamed: D337.2 (A), R337.2
unnamed: D338.2 (A), R338.2
unnamed: D339.2 (A), R339.2
unnamed: D340.2 (A), R340.2
unnamed: D341.2 (A), R341.2
unnamed: D342.2 (A), R342.2
unnamed: D343.2 (A), R343.2
unnamed: D344.2 (A), R344.2
unnamed: D345.2 (A), R345.2
unnamed: D346.2 (A), R346.2
unnamed: D347.2 (A), R347.2
unnamed: D348.2 (A), R348.2
unnamed: D349.2 (A), R349.2
unnamed: D350.2 (A), R350.2
unnamed: D351.2 (A), R351.2
unnamed: D352.2 (A), R352.2
unnamed: D353.2 (A), R353.2
unnamed: D354.2 (A), R354.2
unnamed: D355.2 (A), R355.2
unnamed: D356.2 (A), R356.2
unnamed: D357.2 (A), R357.2
unnamed: D358.2 (A), R358.2
unnamed: D359.2 (A), R359.2
unnamed: D360.2 (A), R360.2
unnamed: D361.2 (A), R361.2
unnamed: D362.2 (A), R362.2
unnamed: D363.2 (A), R363.2
unnamed: D364.2 (A), R364.2
unnamed: D365.2 (A), R365.2
unnamed: D366.2 (A), R366.2
unnamed: D367.2 (A), R367.2
unnamed: D368.2 (A), R368.2
unnamed: D369.2 (A), R369.2
unnamed: D370.2 (A), R370.2
unnamed: D371.2 (A), R371.2
unnamed: D372.2 (A), R372.2
unnamed: D373.2 (A), R373.2
unnamed: D374.2 (A), R374.2
unnamed: D375.2 (A), R375.2
unnamed: D376.2 (A), R376.2
unnamed: D377.2 (A), R377.2
unnamed: D378.2 (A), R378.2
unnamed: D379.2 (A), R379.2
unnamed: D380.2 (A), R380.2
unnamed: D381.2 (A), R381.2
unnamed: D382.2 (A), R382.2
unnamed: D383.2 (A), R383.2
unnamed: D384.2 (A), R384.2
unnamed: D385.2 (A), R385.2
unnamed: D386.2 (A), R386.2
unnamed: D387.2 (A), R387.2
unnamed: D388.2 (A), R388.2
unnamed: D389.2 (A), R389.2
unnamed: D390.2 (A), R390.2
unnamed: D391.2 (A), R391.2
unnamed: D392.2 (A), R392.2
unnamed: D393.2 (A), R393.2
unnamed: D394.2 (A), R394.2
unnamed: D395.2 (A), R395.2
unnamed: D396.2 (A), R396.2
unnamed: D397.2 (A), R397.2
unnamed: D398.2 (A), R398.2
unnamed: D399.2 (A), R399.2
unnamed: D400.2 (A), R400.2
unnamed: D401.2 (A), R401.2
unnamed: D402.2 (A), R402.2
unnamed: D403.2 (A), R403.2
unnamed: D404.2 (A), R404.2
unnamed: D405.2 (A), R405.2
unnamed: D406.2 (A), R406.2
unnamed: D407.2 (A), R407.2
unnamed: D408.2 (A), R408.2
unnamed: D409.2 (A), R409.2
unnamed: D410.2 (A), R410.2
unnamed: D411.2 (A), R411.2
unnamed: D412.2 (A), R412.2
unnamed: D413.2 (A), R413.2
unnamed: D414.2 (A), R414.2
unnamed: D415.2 (A), R415.2
unnamed: D416.2 (A), R416.2
unnamed: D417.2 (A), R417.2
unnamed: D418.2 (A), R418.2
unnamed: D419.2 (A), R419.2
unnamed: D420.2 (A), R420.2
unnamed: D421.2 (A), R421.2
unnamed: D422.2 (A), R422.2
unnamed: D423.2 (A), R423.2
unnamed: D424.2 (A), R424.2
unnamed: D425.2 (A), R425.2
unnamed: D426.2 (A), R426.2
unnamed: D427.2 (A), R427.2
unnamed: D428.2 (A), R428.2
unnamed: D429.2 (A), R429.2
unnamed: D430.2 (A), R430.2
unnamed: D431.2 (A), R431.2
unnamed: D432.2 (A), R432.2
unnamed: D433.2 (A), R433.2
unnamed: D434.2 (A), R434.2
unnamed: D435.2 (A), R435.2
unnamed: D436.2 (A), R436.2
unnamed: D437.2 (A), R437.2
unnamed: D438.2 (A), R438.2
unnamed: D439.2 (A), R439.2
unnamed: D440.2 (A), R440.2
unnamed: D441.2 (A), R441.2
unnamed: D442.2 (A), R442.2
unnamed: D443.2 (A), R443.2
unnamed: D444.2 (A), R444.2
unnamed: D445.2 (A), R445.2
unnamed: D446.2 (A), R446.2
unnamed: D447.2 (A), R447.2
unnamed: D448.2 (A), R448.2
unnamed: D449.2 (A), R449.2
unnamed: D450.2 (A), R450.2
unnamed: D451.2 (A), R451.2
unnamed: D452.2 (A), R452.2
unnamed: D453.2 (A), R453.2
unnamed: D454.2 (A), R454.2
unnamed: D455.2 (A), R455.2
unnamed: D456.2 (A), R456.2
unnamed: D457.2 (A), R457.2
unnamed: D458.2 (A), R458.2
unnamed: D459.2 (A), R459.2
unnamed: D460.2 (A), R460.2
unnamed: D461.2 (A), R461.2
unnamed: D462.2 (A), R462.2
unnamed: D463.2 (A), R463.2
unnamed: D464.2 (A), R464.2
unnamed: D465.2 (A), R465.2
unnamed: D466.2 (A), R466.2
unnamed: D467.2 (A), R467.2
unnamed: D468.2 (A), R468.2
unnamed: D469.2 (A), R469.2
unnamed: D470.2 (A), R470.2
unnamed: D471.2 (A), R471.2
unnamed: D472.2 (A), R472.2
unnamed: D473.2 (A), R473.2
unnamed: D474.2 (A), R474.2
unnamed: D475.2 (A), R475.2
unnamed: D476.2 (A), R476.2
unnamed: D477.2 (A), R477.2
unnamed: D478.2 (A), R478.2
unnamed: D479.2 (A), R479.2
unnamed: D480.2 (A), R480.2
unnamed: D481.2 (A), R481.2
unnamed: D482.2 (A), R482.2
unnamed: D483.2 (A), R483.2
unnamed: D484.2 (A), R484.2
unnamed: D485.2 (A), R485.2
unnamed: D486.2 (A), R486.2
unnamed: D487.2 (A), R487.2
unnamed: D488.2 (A), R488.2
unnamed: D489.2 (A), R489.2
unnamed: D490.2 (A), R490.2
unnamed: D491.2 (A), R491.2
unnamed: D492.2 (A), R492.2
unnamed: D493.2 (A), R493.2
unnamed: D494.2 (A), R494.2
unnamed: D495.2 (A), R495.2
unnamed: D496.2 (A), R496.2
unnamed: D497.2 (A), R497.2
unnamed: D498.2 (A), R498.2
unnamed: D499.2 (A), R499.2
unnamed: D500.2 (A), R500.2
unnamed: D501.2 (A), R501.2
unnamed: D502.2 (A), R502.2
unnamed: D503.2 (A), R503.2
unnamed: D504.2 (A), R504.2
unnamed: D505.2 (A), R505.2
unnamed: D506.2 (A), R506.2
unnamed: D507.2 (A), R507.2
unnamed: D508.2 (A), R508.2
unnamed: D509.2 (A), R509.2
unnamed: D510.2 (A), R510.2
unnamed: D511.2 (A), R511.2
unnamed: D512.2 (A), R512.2
unnamed: D513.2 (A), R513.2
unnamed: D514.2 (A), R514.2
unnamed: D515.2 (A), R515.2
unnamed: D516.2 (A), R516.2
unnamed: D517.2 (A), R517.2
unnamed: D518.2 (A), R518.2
unnamed: D519.2 (A), R519.2
unnamed: D520.2 (A), R520.2
unnamed: D521.2 (A), R521.2
unnamed: D522.2 (A), R522.2
unnamed: D523.2 (A), R523.2
unnamed: D524.2 (A), R524.2
unnamed: D525.2 (A), R525.2
unnamed: D526.2 (A), R526.2
unnamed: D527.2 (A), R527.2
unnamed: D528.2 (A), R528.2

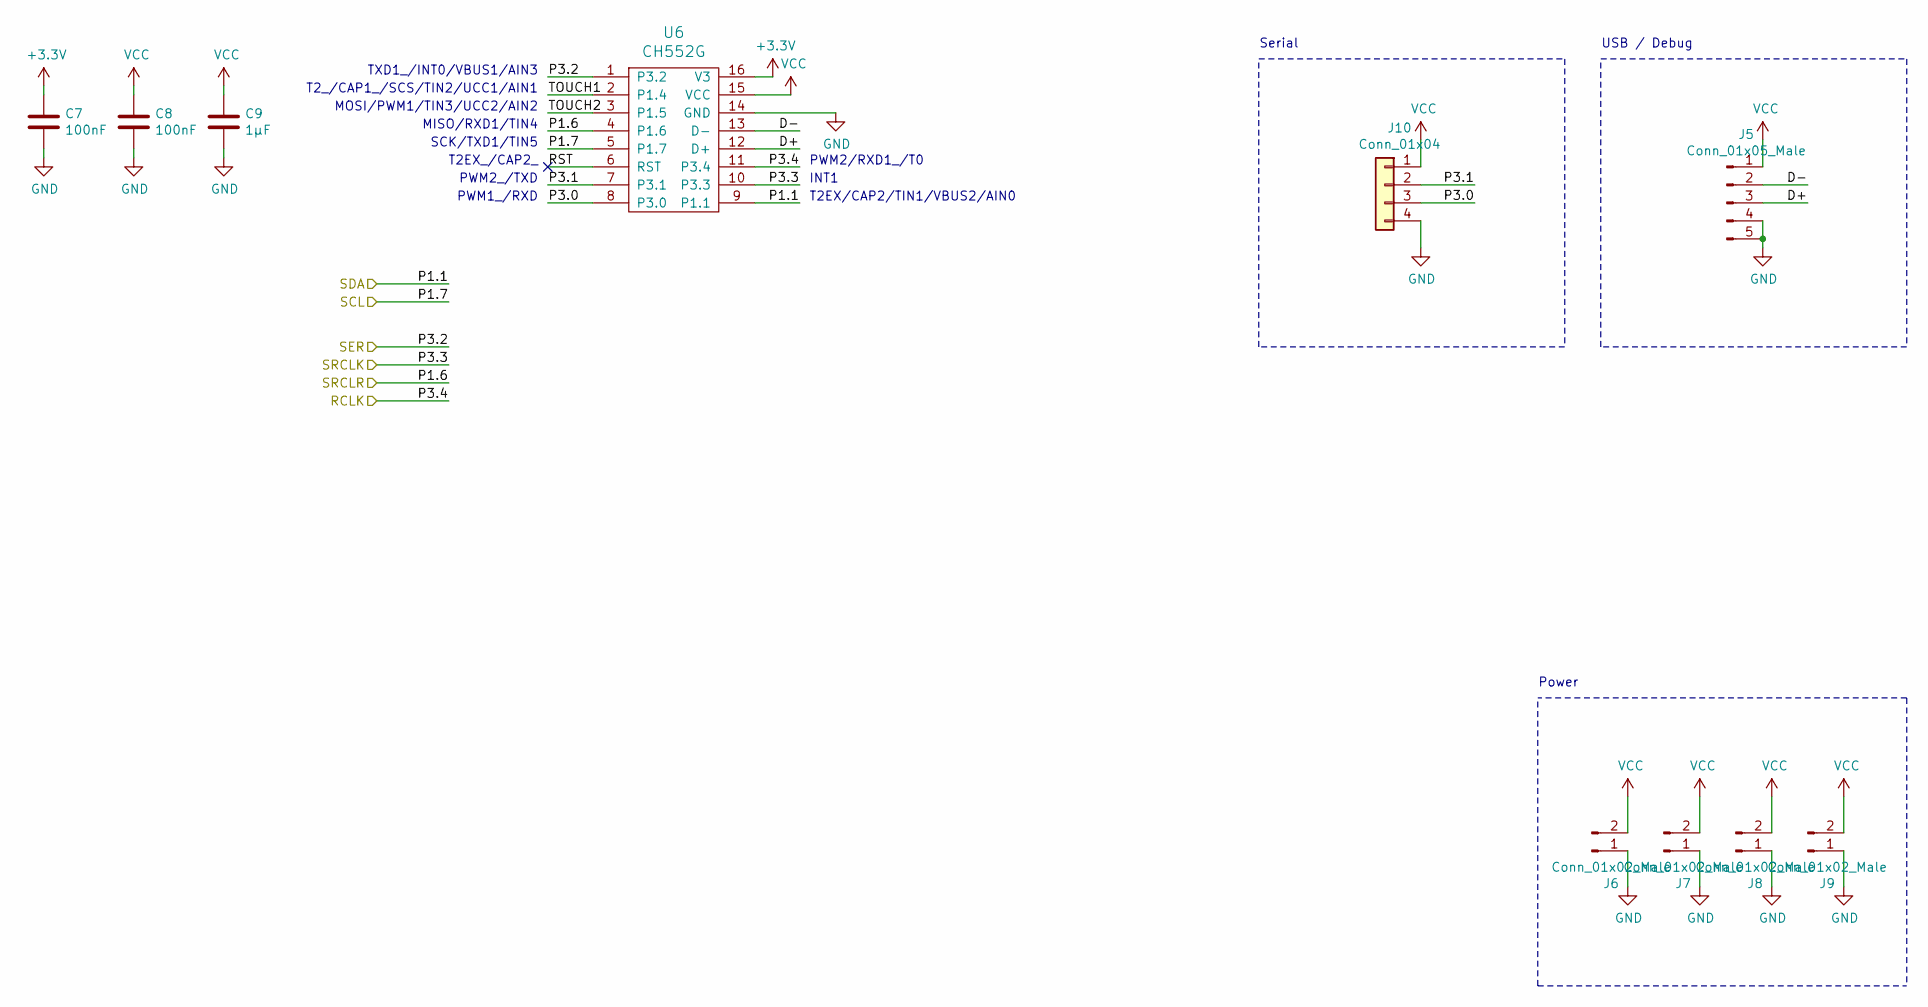
[picture p5: schematic CH552G-Controller.sch]

Parts:
C7, C8: 100nF; C_0603_1608Metric
C9: 1µF; C_0603_1608Metric
J5: Conn_01x05_Male; PinHeader_1x05_P2.54mm_Vertical
J6, J7, J8, J9: Conn_01x02_Male; PinHeader_1x02_P2.54mm_Vertical
J10: Conn_01x04; PinHeader_1x04_P2.54mm_Vertical
U6: CH552G; SOP-16_4.4x10.4mm_P1.27mm

Connections:
+3V3: C7.1, U6.16 (V3)
/CH552G-Controller/D+: J5.3, U6.12 (D+)
/CH552G-Controller/D-: J5.2, U6.13 (D-)
/CH552G-Controller/P3.0: J10.3, U6.8 (P3.0)
/CH552G-Controller/P3.1: J10.2, U6.7 (P3.1)
/CH552G-Controller/TOUCH1: U6.2 (P1.4)
/CH552G-Controller/TOUCH2: U6.3 (P1.5)
/RCLK: U6.11 (P3.4); also elsewhere on the board
/SCL: U6.5 (P1.7); also elsewhere on the board
/SDA: U6.9 (P1.1); also elsewhere on the board
/SER: U6.1 (P3.2); also elsewhere on the board
/SRCLK: U6.10 (P3.3); also elsewhere on the board
/SRCLR: U6.4 (P1.6); also elsewhere on the board
GND: C7.2, C8.2, C9.2, J5.4, J5.5, J6.1, J7.1, J8.1, J9.1, J10.4, U6.14 (GND); also elsewhere on the board
VCC: C8.1, C9.1, J5.1, J6.2, J7.2, J8.2, J9.2, J10.1, U6.15 (VCC); also elsewhere on the board

Notes on the sheet:
PWM2/RXD1_/T0
INT1
T2EX/CAP2/TIN1/VBUS2/AIN0
TXD1_/INT0/VBUS1/AIN3
T2_/CAP1_/SCS/TIN2/UCC1/AIN1
MOSI/PWM1/TIN3/UCC2/AIN2
MISO/RXD1/TIN4
SCK/TXD1/TIN5
T2EX_/CAP2_
PWM2_/TXD
PWM1_/RXD
USB / Debug
Power
Serial
