andreasb242/WordClockPcb/ElektronikV2/Elektronik.kicad_pcb

## KiCad design ElektronikV2/Elektronik.kicad_pcb (continued)

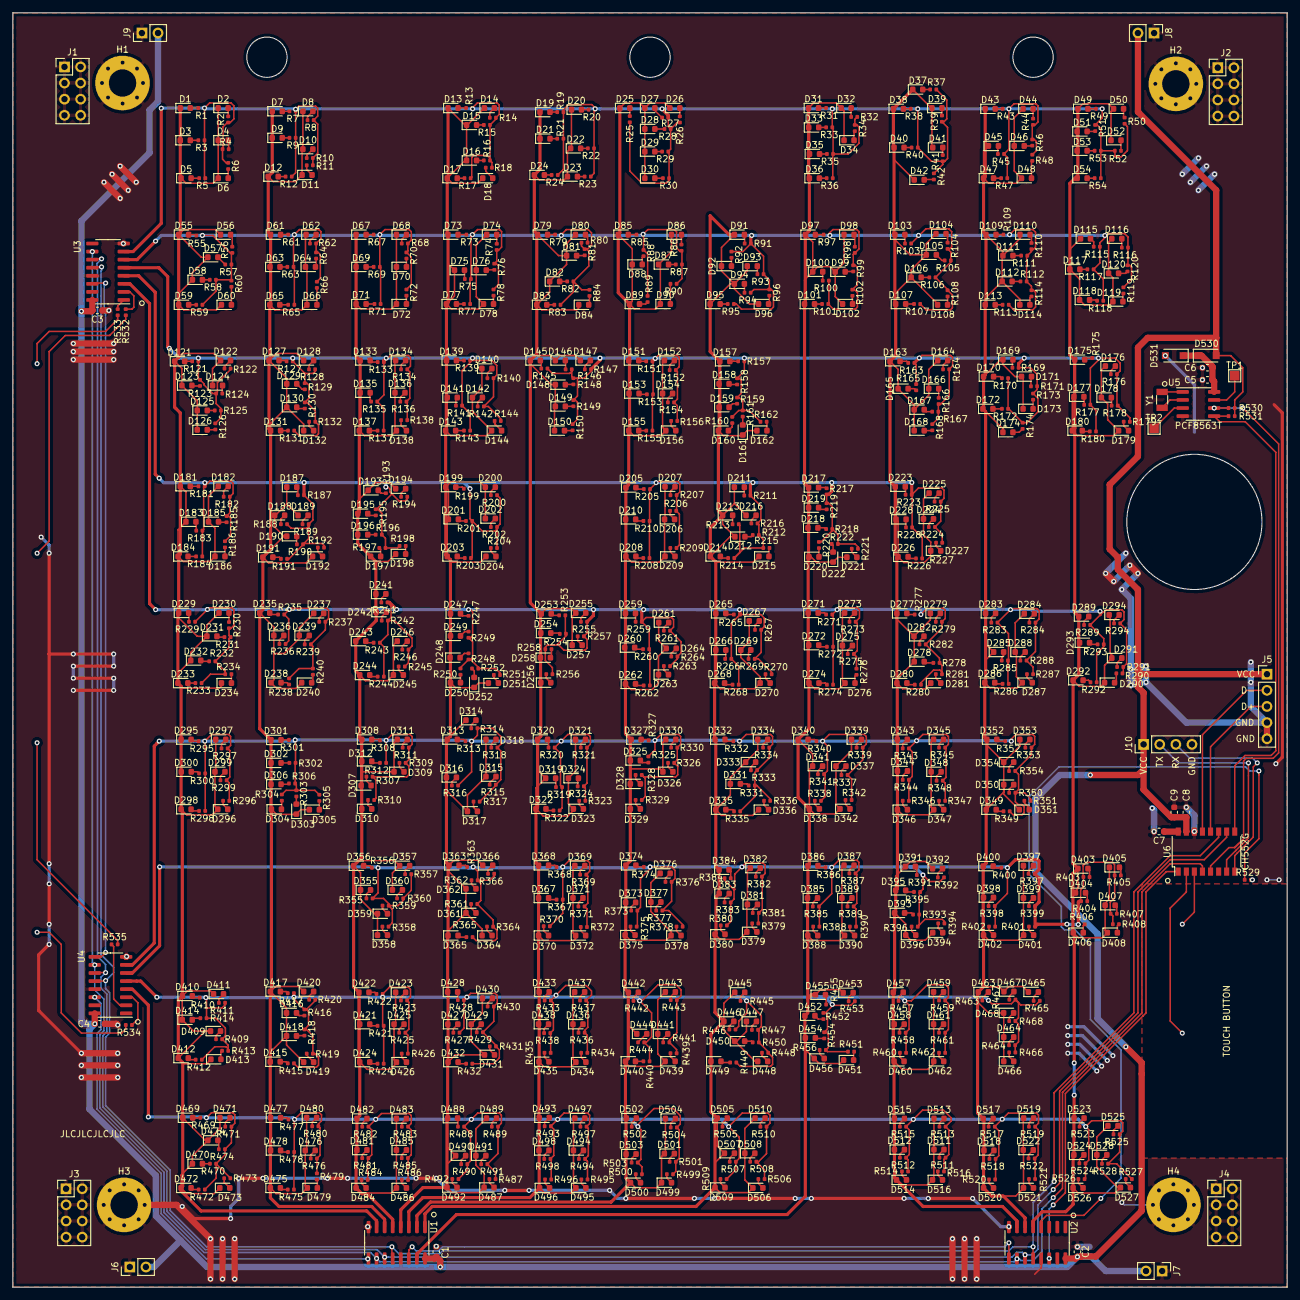
[picture p6: board Elektronik.kicad_pcb from above]

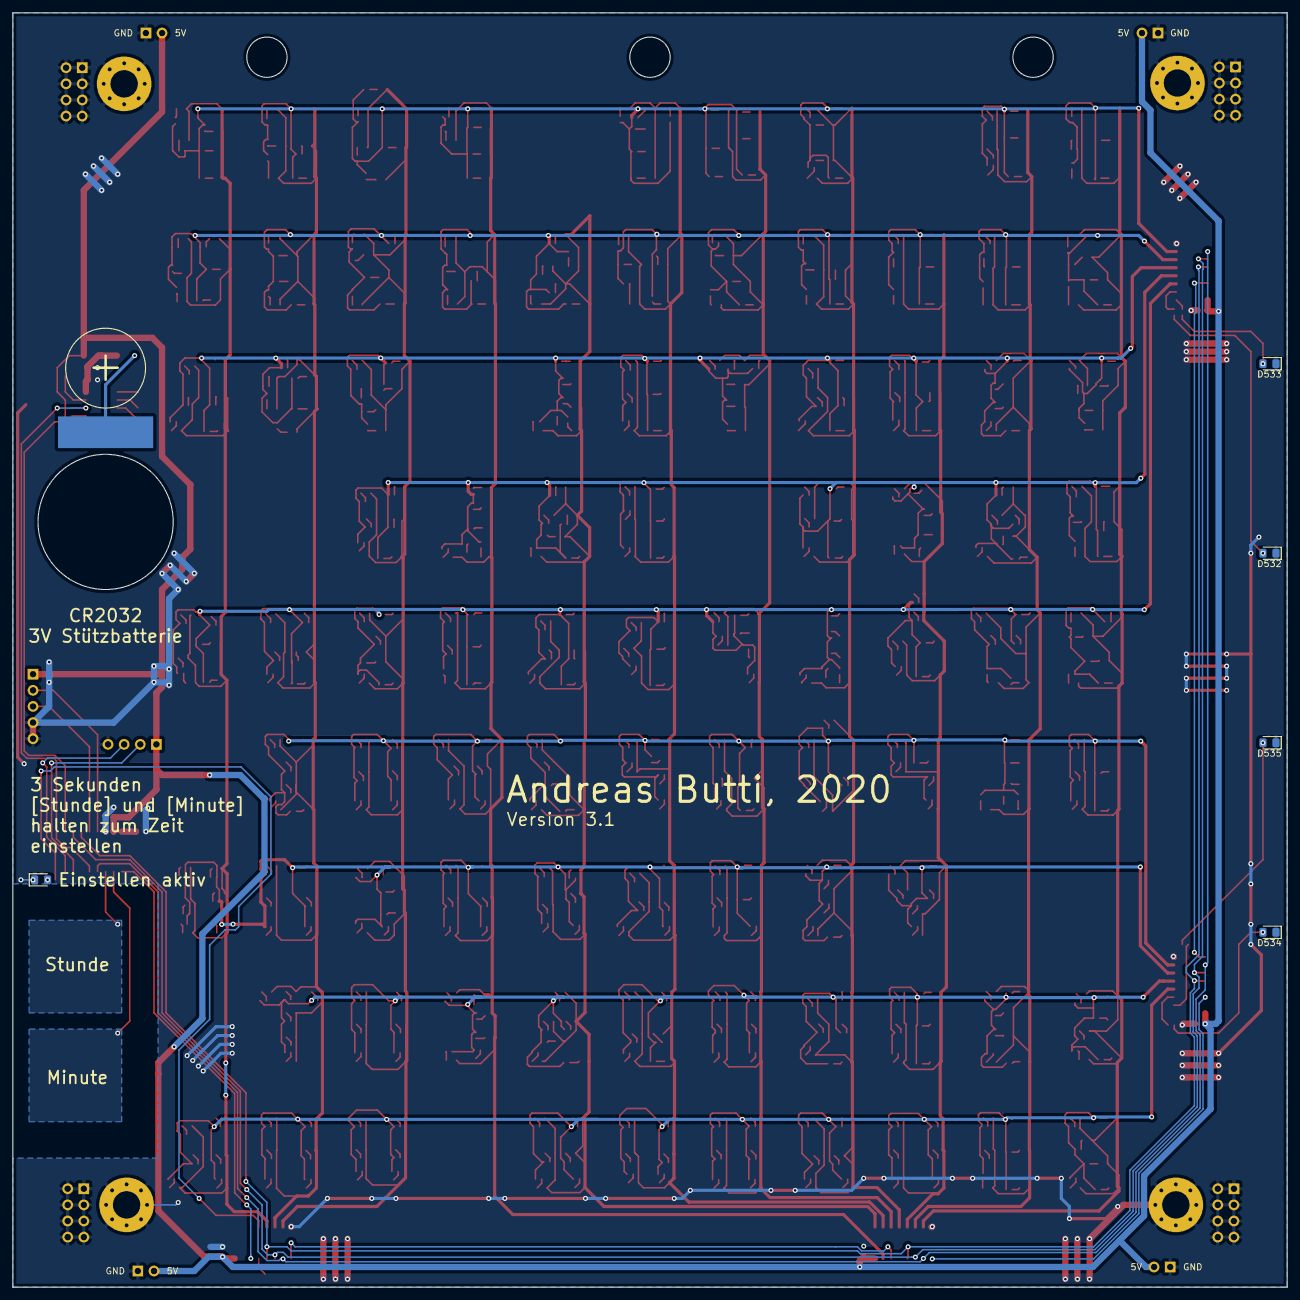
[picture p7: board Elektronik.kicad_pcb from below]

Board: 2 copper layers, 200.7 x 200.7 mm, 1104 parts (6 on the bottom side), 580 nets.
