andreasb242/WordClockPcb/software/logic.h

/**
 * Main Project Logic
 *
 * Andreas Butti, (c) 2020
 * License: MIT
 */

#pragma once

#include "lib/inc.h"

/**
 * Initialize Hardware
 */
void logicInit();

/**
 * Called from the main loop
 */
void logicLoop();

/**
 * Called for each received char
 *
 * @param c Received char
 */
void logicCharReceived(char c);

/**
 * Called before device gets powered down by USB
 */
void logicPowerDown();
