andreasb242/WordClockPcb/(commit log)

2020-09-03 Initial Import for Github
    [BOM-Elektronik.csv.jlcpcb.xlsx, CH552G-Controller.sch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]
2020-09-03 Fixed clock set over touch buttons
    [logic.c]
2020-09-25 Board HW Ref 2 Checked in
    [BOM-Elektronik.csv.jlcpcb.xlsx, CH552G-Controller.sch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]
2020-09-27 Background LEDs working
2020-09-28 Allow to switch to Bootloader with char 'b'
2020-09-30 Fixed "Eins", Version added
    [TextDisplay.c, logic.c]
